BugajLab/thermoPlate/thermoPlate model_ShinyApp/simPlaceHolder.png

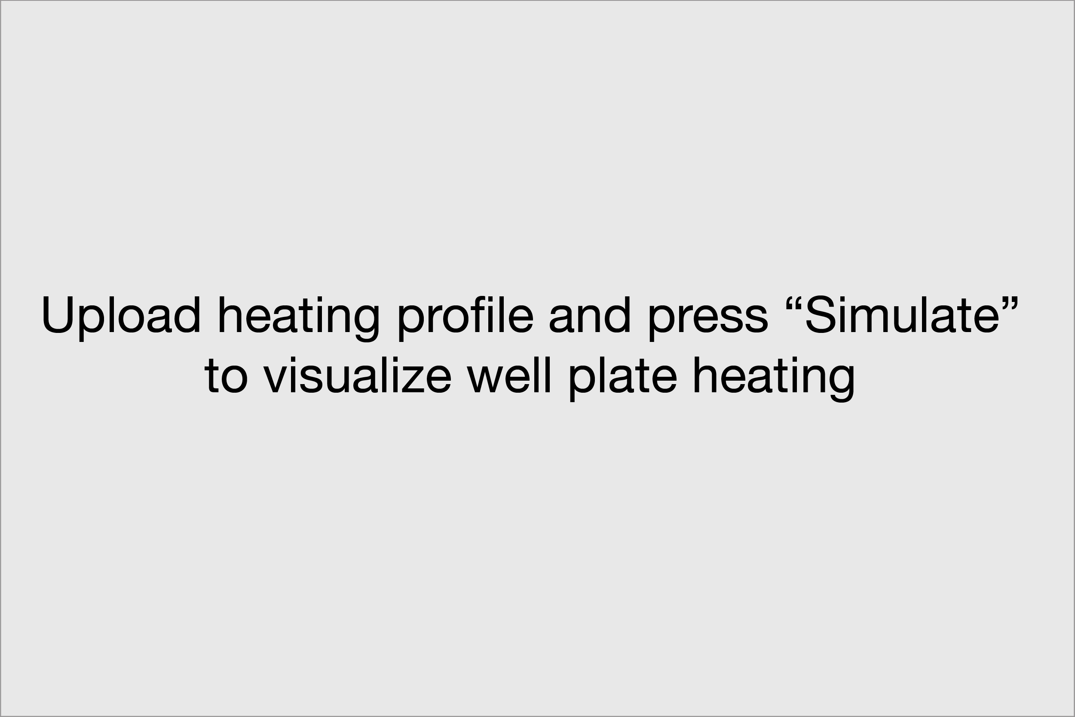
thermoPlate model_ShinyApp/simPlaceHolder.png
