BugajLab/thermoPlate/thermoPlate model_ShinyApp/www/test.gif

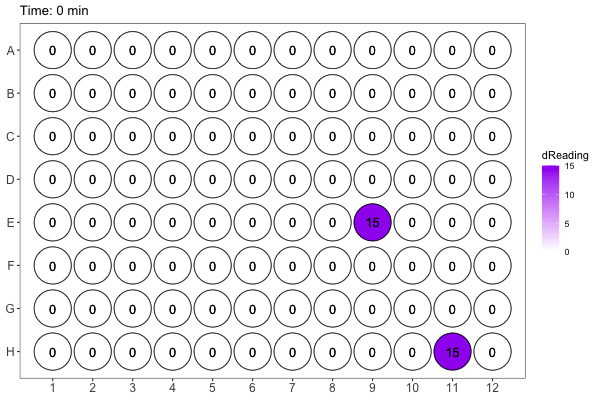
thermoPlate model_ShinyApp/www/test.gif
