BugajLab/thermoPlate/Design files_protocols_manuals/ThermoPlate PCB files/ThermoPlate2_v1.kicad_pcb

## KiCad design Design files_protocols_manuals/ThermoPlate PCB files/ThermoPlate2_v1.kicad_pcb (2024-08-28)

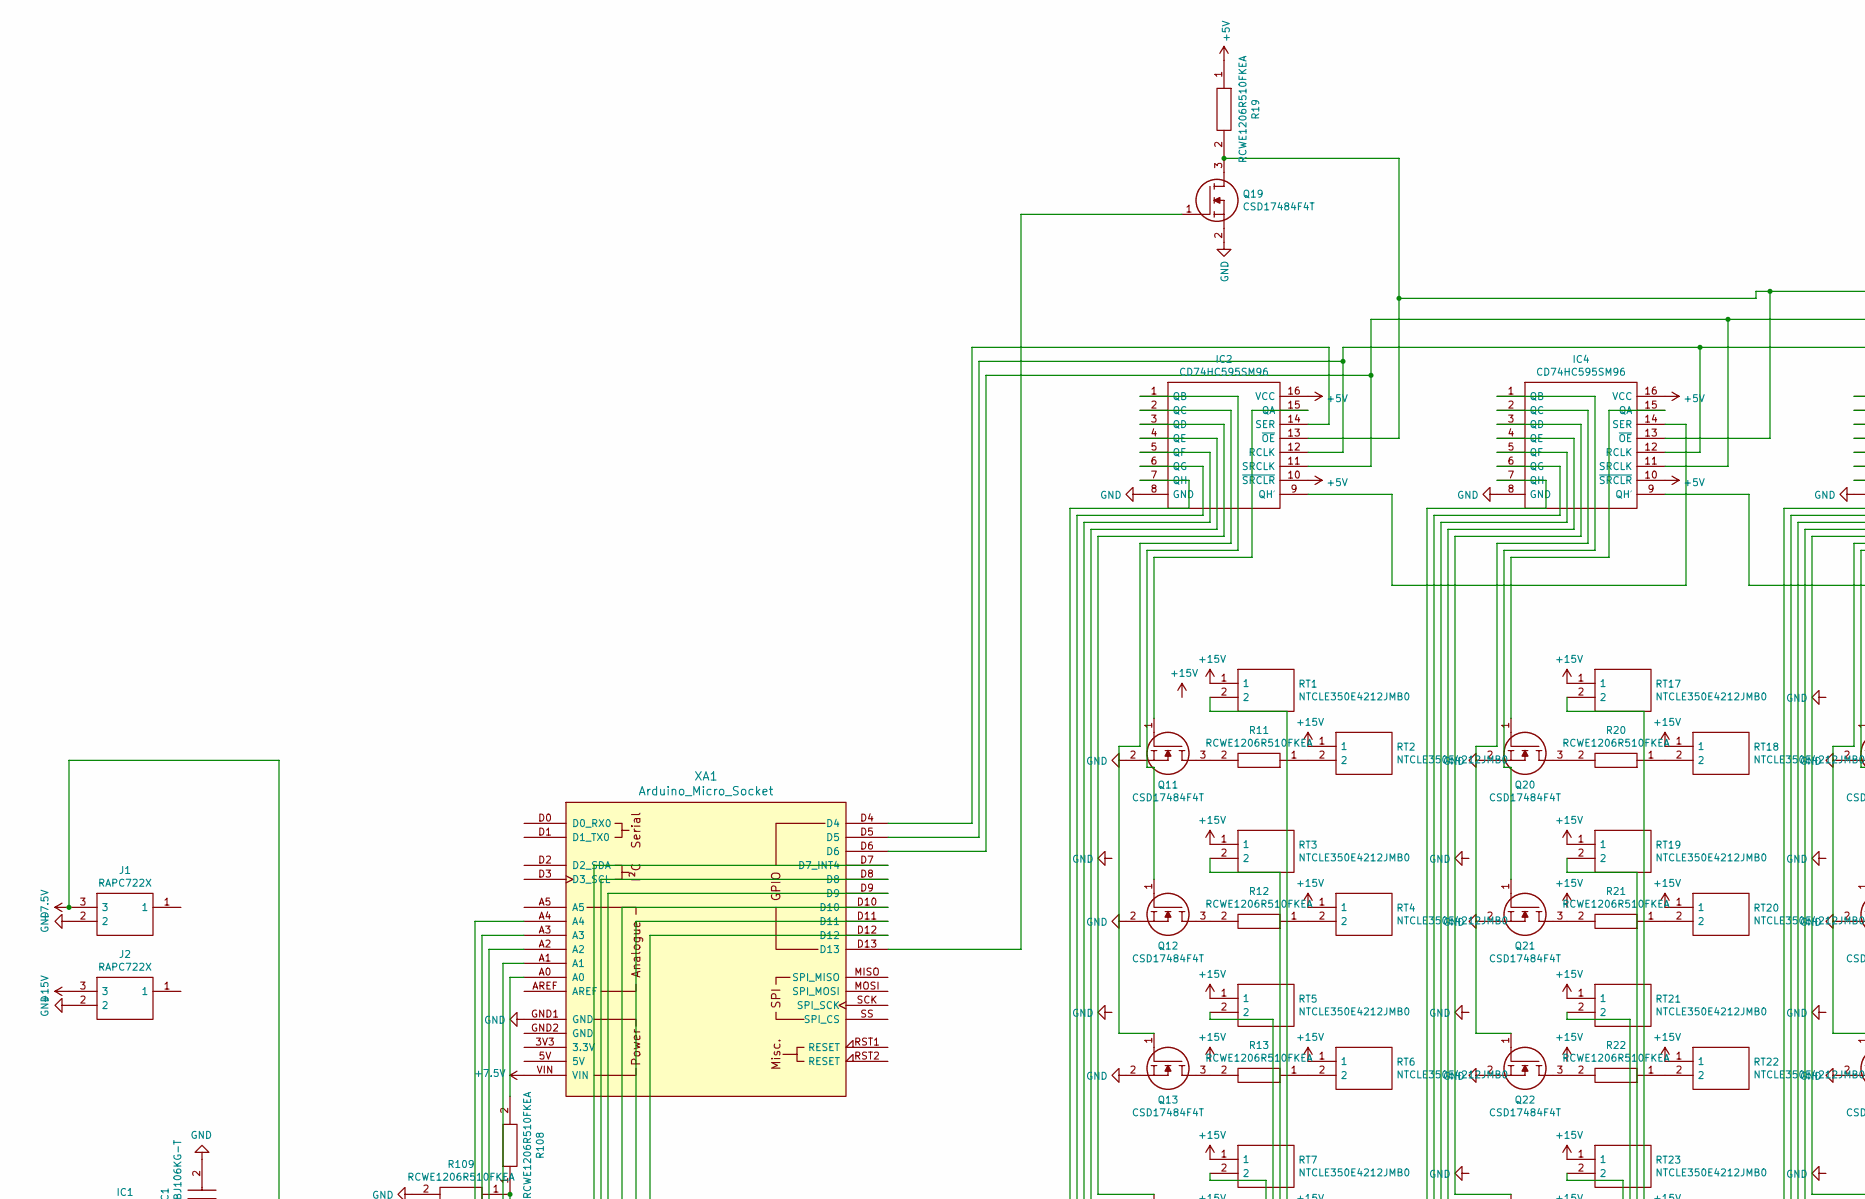
[picture p8: schematic ThermoPlate2_v1.sch, part in row 1, column 1]

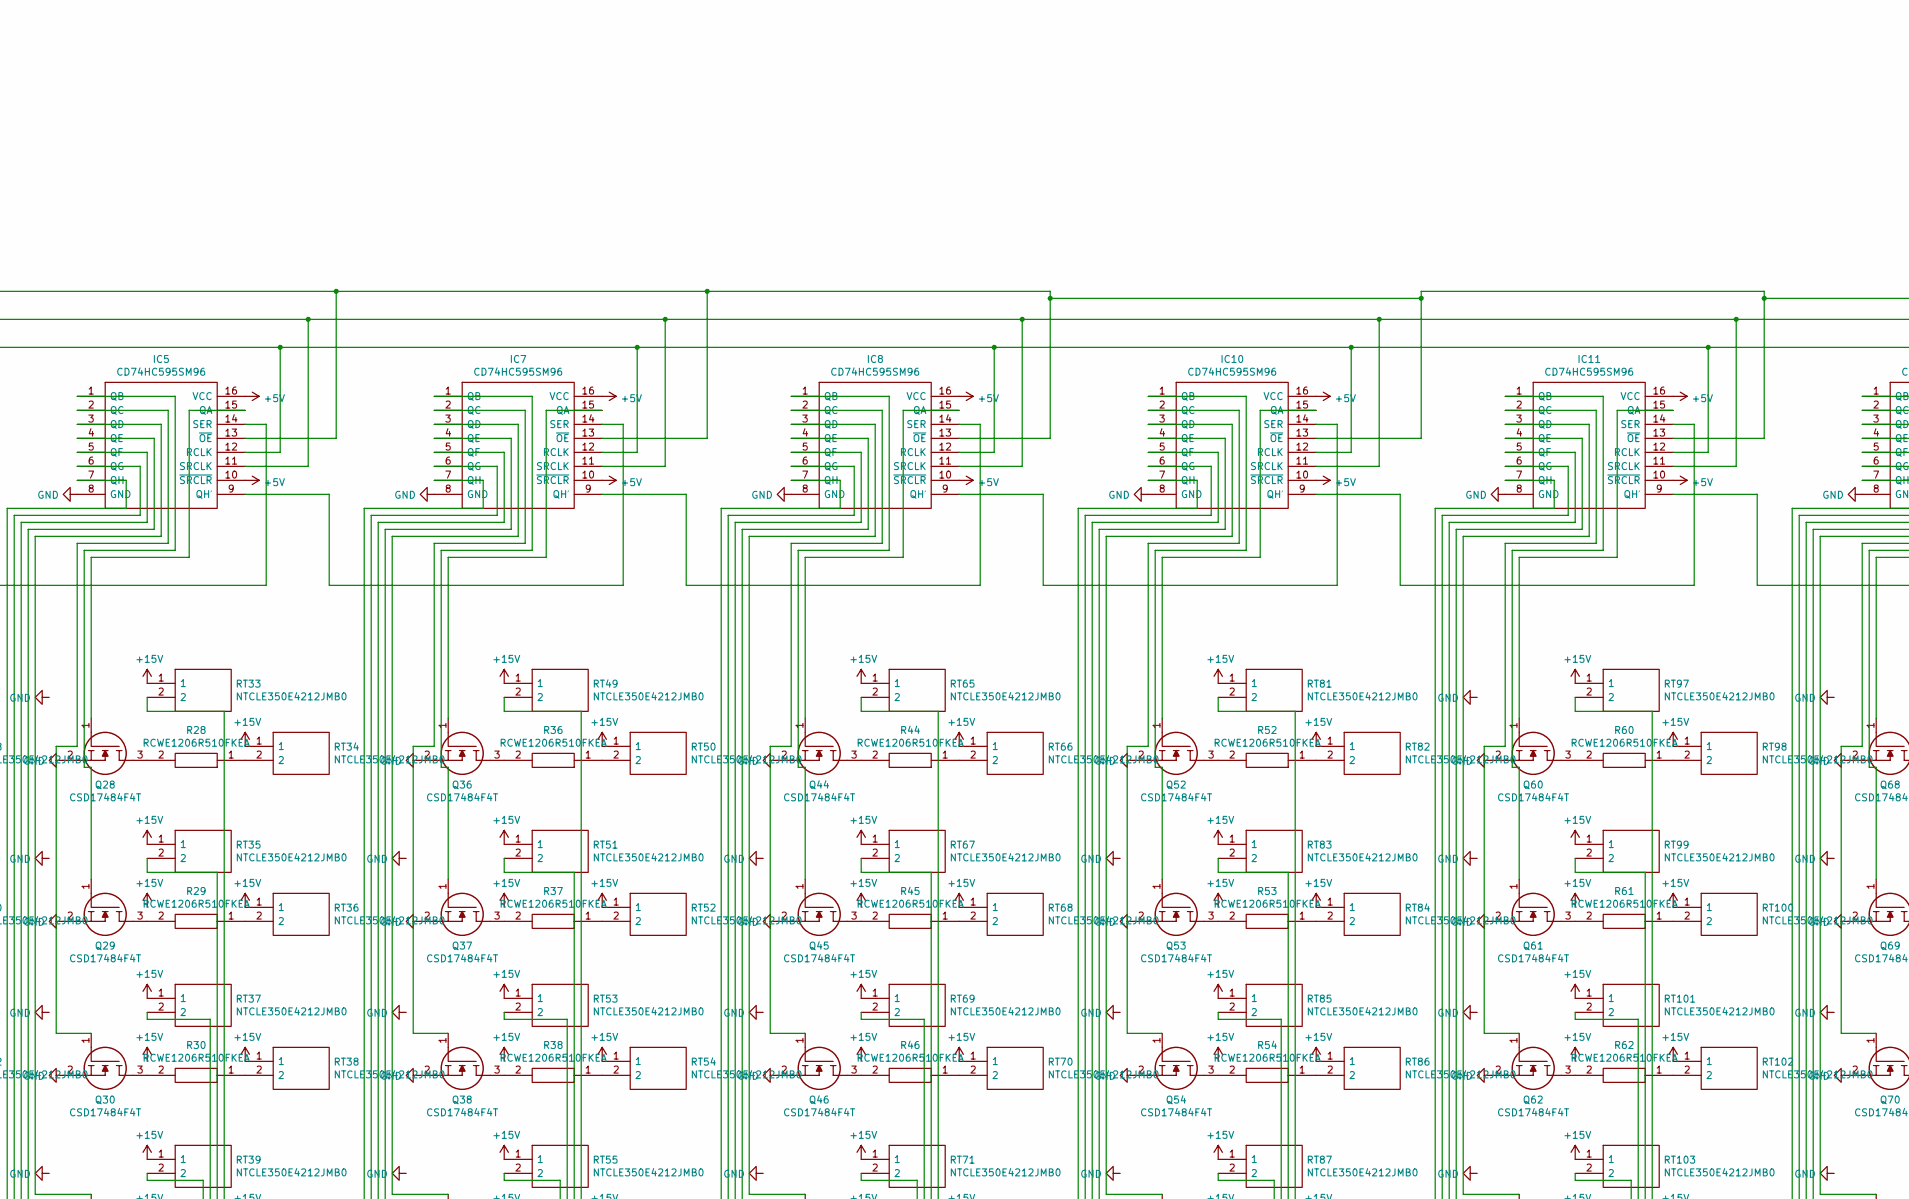
[picture p9: schematic ThermoPlate2_v1.sch, part in row 1, column 2]

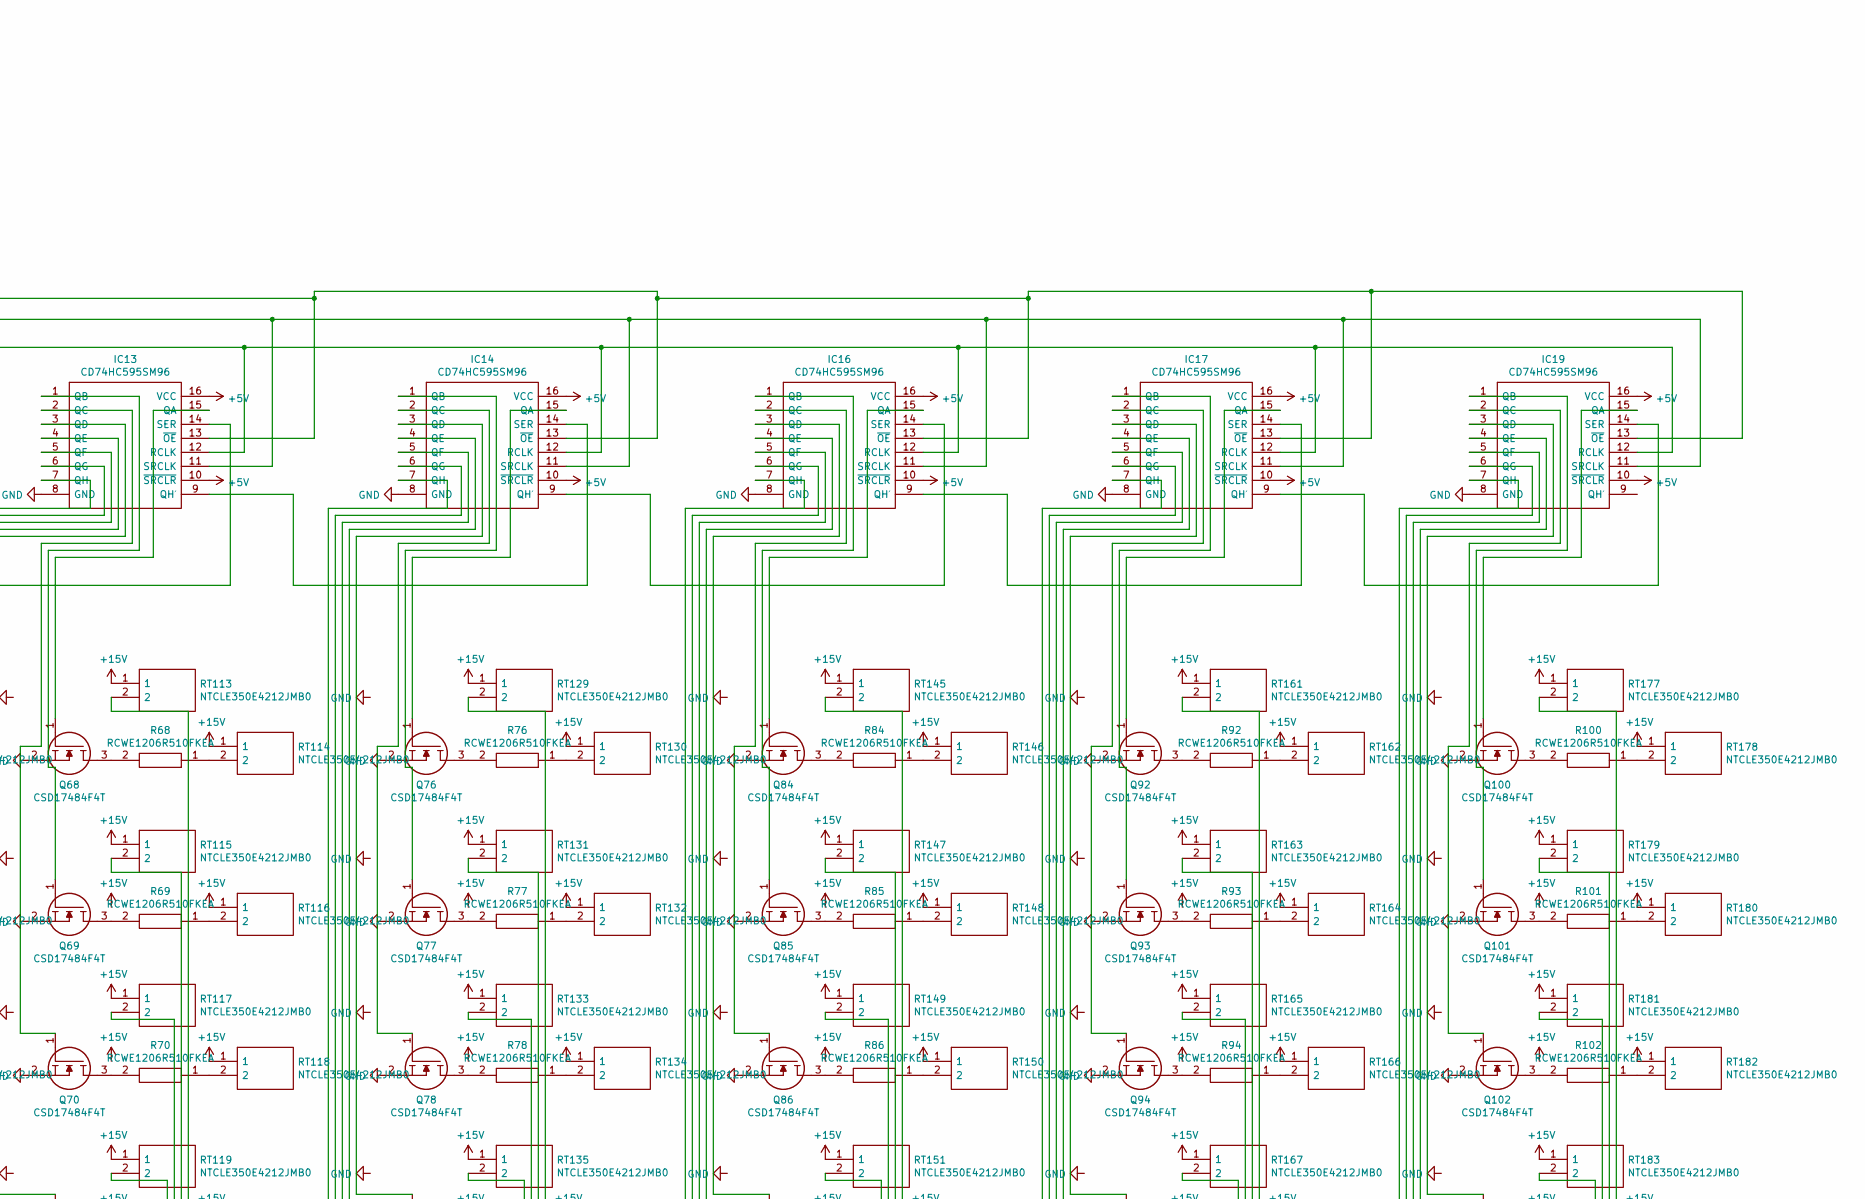
[picture p10: schematic ThermoPlate2_v1.sch, part in row 1, column 3]

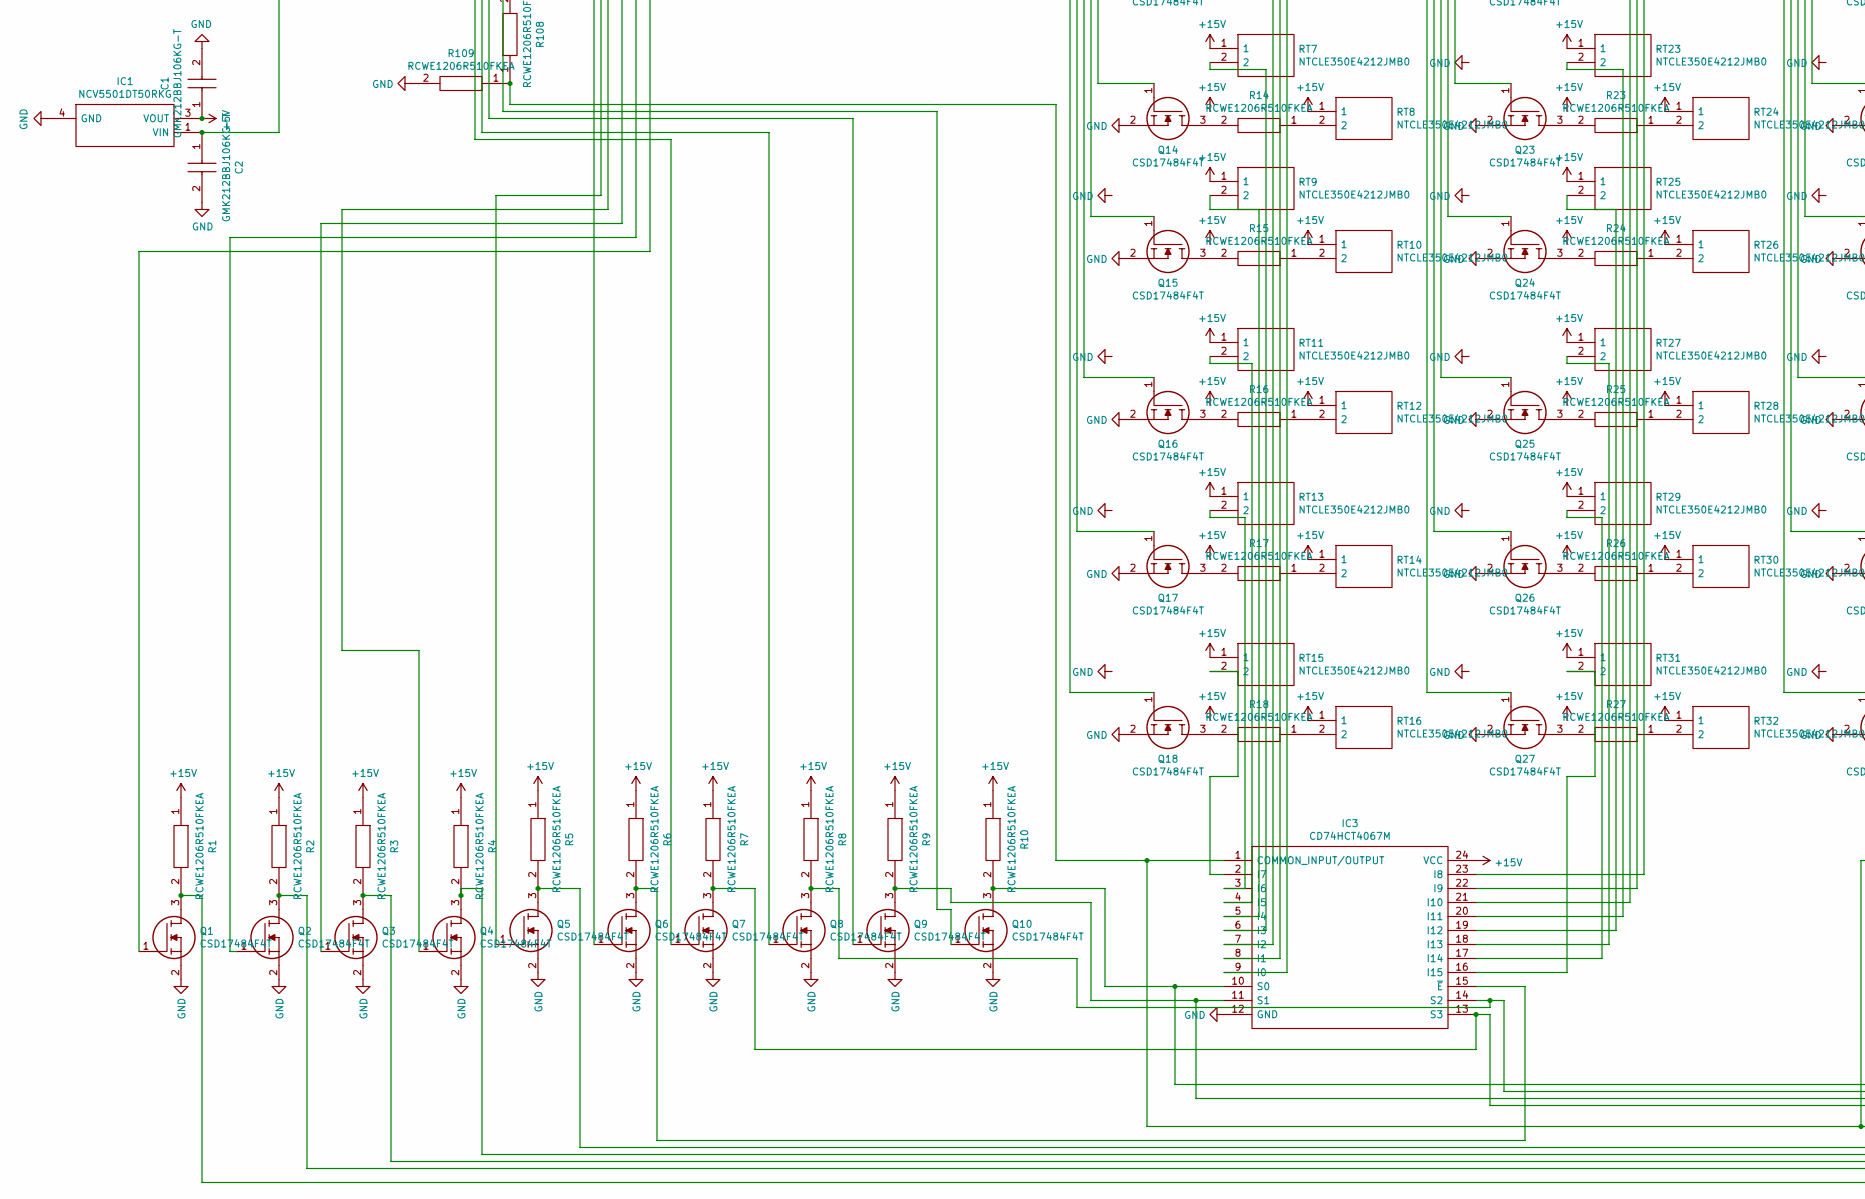
[picture p11: schematic ThermoPlate2_v1.sch, part in row 2, column 1]

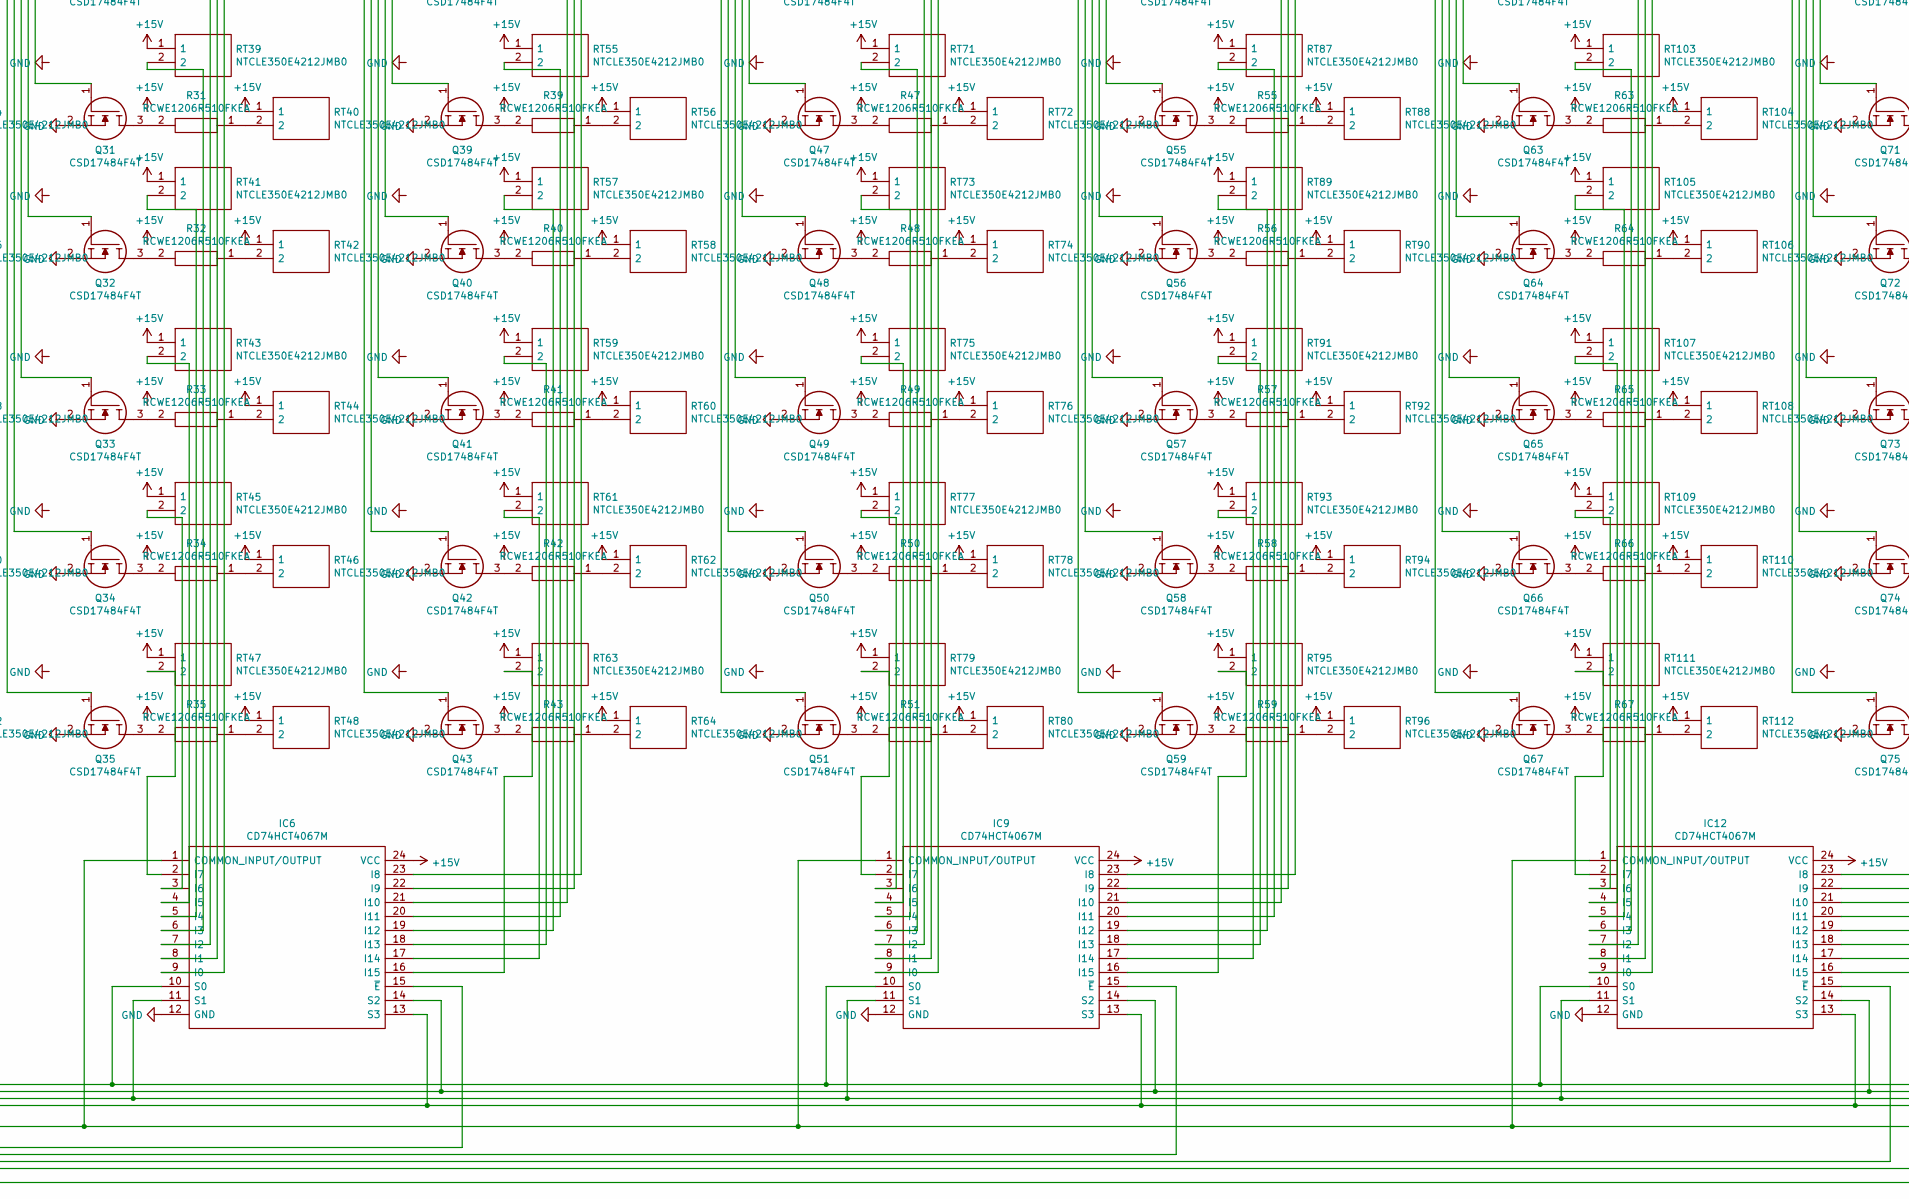
[picture p12: schematic ThermoPlate2_v1.sch, part in row 2, column 2]

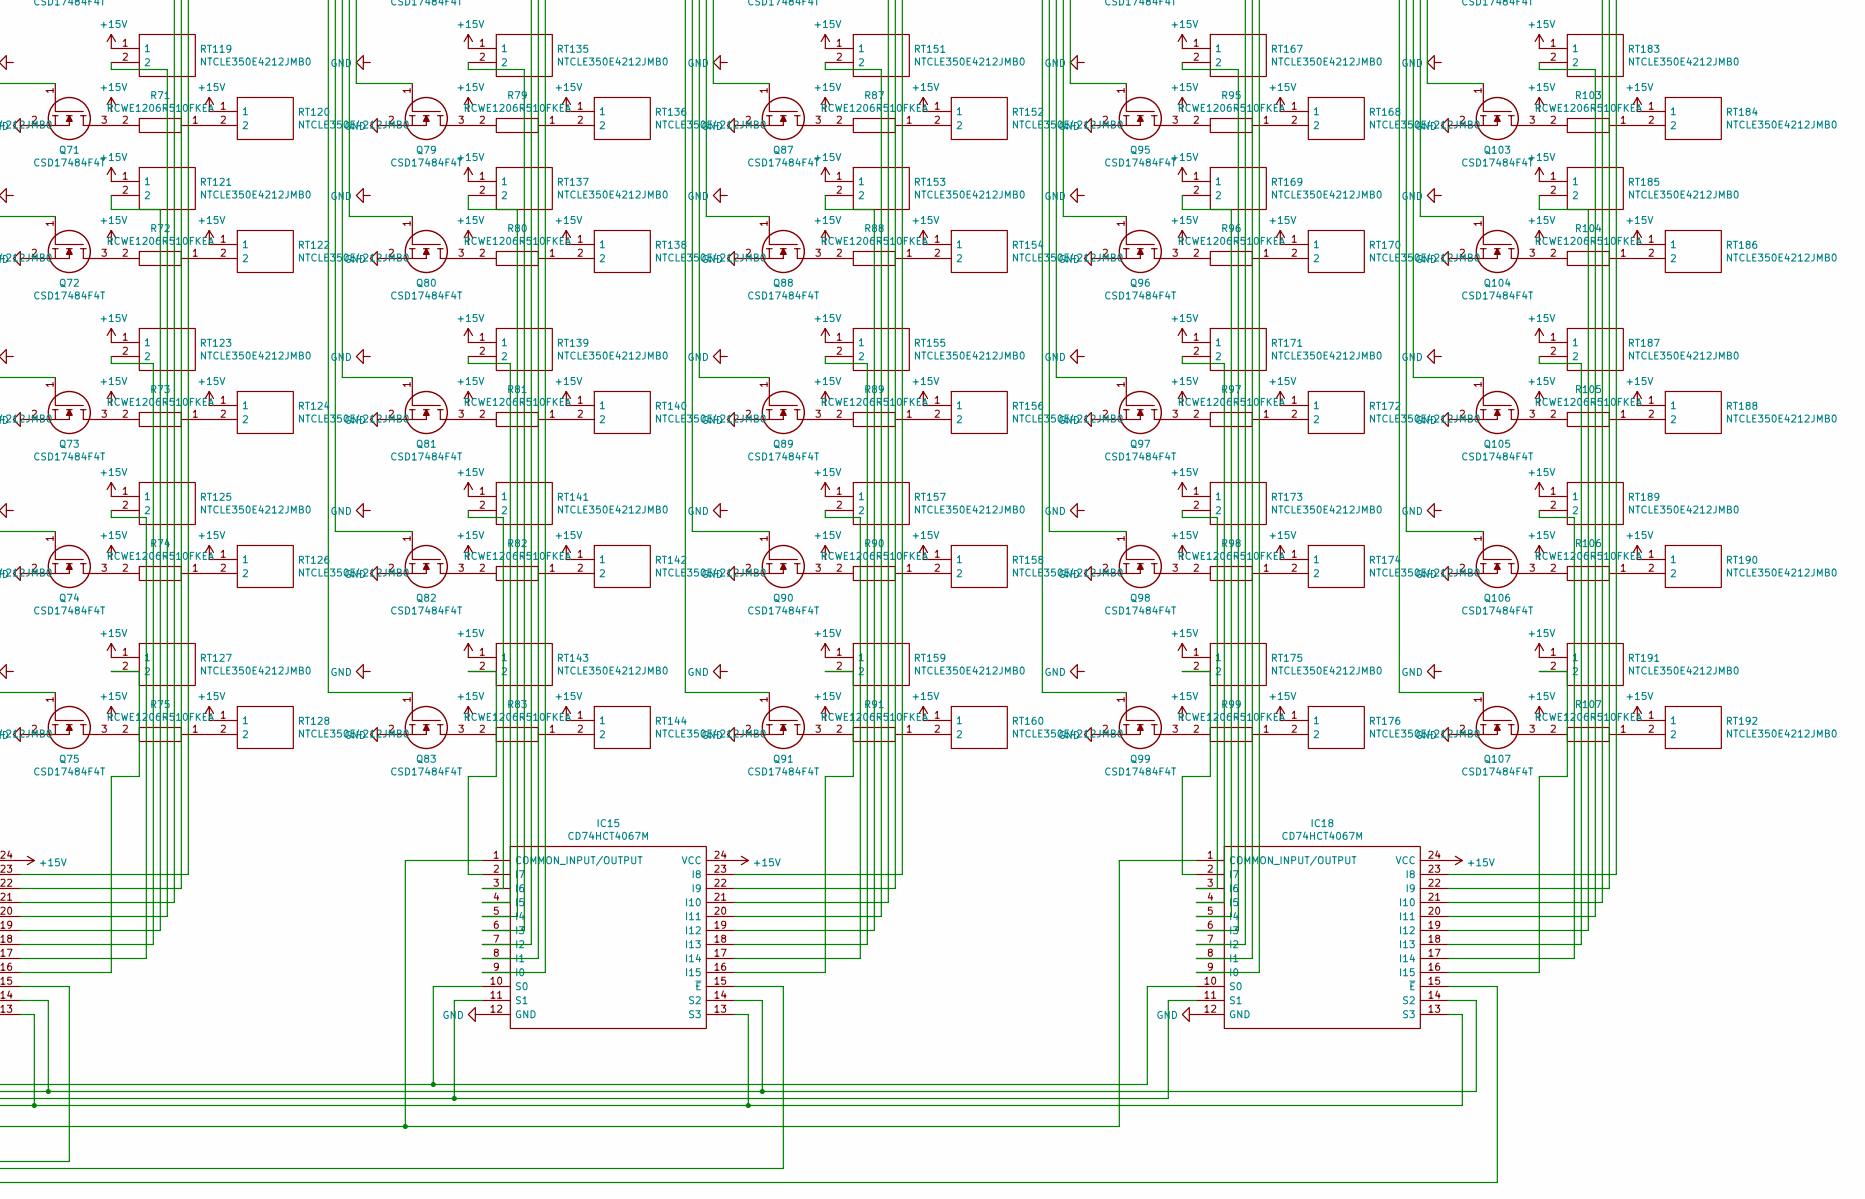
[picture p13: schematic ThermoPlate2_v1.sch, part in row 2, column 3]

Parts:
C1, C2: GMK212BBJ106KG-T; CAPC2012X135N; Mouser Part Number 963-GMK212BBJ106KG-T
IC1: NCV5501DT50RKG; Mouser Part Number 863-NCV5501DT50RKG
IC2, IC4, IC5, IC7, IC8, IC10, IC11, IC13, IC14, IC16, IC17, IC19: CD74HC595SM96; SOP65P780X200-16N; Mouser Part Number 595-CD74HC595SM96
IC3, IC6, IC9, IC12, IC15, IC18: CD74HCT4067M; SOIC127P1030X265-24N; Mouser Part Number 595-CD74HCT4067M
J1, J2: RAPC722X; Mouser Part Number 502-RAPC722X
Q1, Q2, Q3, Q4, Q5, Q6, Q7, Q8, Q9, Q10, Q11, Q12, Q13, Q14, Q15, Q16, Q17, Q18, Q19, Q20, Q21, Q22, Q23, Q24, Q25, Q26, Q27, Q28, Q29, Q30, Q31, Q32, Q33, Q34, Q35, Q36, Q37, Q38, Q39, Q40, Q41, Q42, Q43, Q44, Q45, Q46, Q47, Q48, Q49, Q50, Q51, Q52, Q53, Q54, Q55, Q56, Q57, Q58, Q59, Q60, Q61, Q62, Q63, Q64, Q65, Q66, Q67, Q68, Q69, Q70, Q71, Q72, Q73, Q74, Q75, Q76, Q77, Q78, Q79, Q80, Q81, Q82, Q83, Q84, Q85, Q86, Q87, Q88, Q89, Q90, Q91, Q92, Q93, Q94, Q95, Q96, Q97, Q98, Q99, Q100, Q101, Q102, Q103, Q104, Q105, Q106, Q107: CSD17484F4T; SOT95P230X110-3N; Mouser Part Number 595-CSD17484F4T
R1, R2, R3, R4, R5, R6, R7, R8, R9, R10, R11, R12, R13, R14, R15, R16, R17, R18, R19, R20, R21, R22, R23, R24, R25, R26, R27, R28, R29, R30, R31, R32, R33, R34, R35, R36, R37, R38, R39, R40, R41, R42, R43, R44, R45, R46, R47, R48, R49, R50, R51, R52, R53, R54, R55, R56, R57, R58, R59, R60, R61, R62, R63, R64, R65, R66, R67, R68, R69, R70, R71, R72, R73, R74, R75, R76, R77, R78, R79, R80, R81, R82, R83, R84, R85, R86, R87, R88, R89, R90, R91, R92, R93, R94, R95, R96, R97, R98, R99, R100, R101, R102, R103, R104, R105, R106, R107, R108, R109: RCWE1206R510FKEA; RESC3216X71N; Mouser Part Number 71-RCWE1206R510FKEA
RT1, RT2, RT3, RT4, RT5, RT6, RT7, RT8, RT9, RT10, RT11, RT12, RT13, RT14, RT15, RT16, RT17, RT18, RT19, RT20, RT21, RT22, RT23, RT24, RT25, RT26, RT27, RT28, RT29, RT30, RT31, RT32, RT33, RT34, RT35, RT36, RT37, RT38, RT39, RT40, RT41, RT42, RT43, RT44, RT45, RT46, RT47, RT48, RT49, RT50, RT51, RT52, RT53, RT54, RT55, RT56, RT57, RT58, RT59, RT60, RT61, RT62, RT63, RT64, RT65, RT66, RT67, RT68, RT69, RT70, RT71, RT72, RT73, RT74, RT75, RT76, RT77, RT78, RT79, RT80, RT81, RT82, RT83, RT84, RT85, RT86, RT87, RT88, RT89, RT90, RT91, RT92, RT93, RT94, RT95, RT96, RT97, RT98, RT99, RT100, RT101, RT102, RT103, RT104, RT105, RT106, RT107, RT108, RT109, RT110, RT111, RT112, RT113, RT114, RT115, RT116, RT117, RT118, RT119, RT120, RT121, RT122, RT123, RT124, RT125, RT126, RT127, RT128, RT129, RT130, RT131, RT132, RT133, RT134, RT135, RT136, RT137, RT138, RT139, RT140, RT141, RT142, RT143, RT144, RT145, RT146, RT147, RT148, RT149, RT150, RT151, RT152, RT153, RT154, RT155, RT156, RT157, RT158, RT159, RT160, RT161, RT162, RT163, RT164, RT165, RT166, RT167, RT168, RT169, RT170, RT171, RT172, RT173, RT174, RT175, RT176, RT177, RT178, RT179, RT180, RT181, RT182, RT183, RT184, RT185, RT186, RT187, RT188, RT189, RT190, RT191, RT192: NTCLE350E4212JMB0; NTCLE350E4103FHB0; Mouser Part Number 594-NTCLE350E4212JMB
XA1: Arduino_Micro_Socket

Connections:
+5V: C1.1, IC1.3 (VOUT), IC2.10 (~SRCLR), IC2.16 (VCC), IC4.10 (~SRCLR), IC4.16 (VCC), IC5.10 (~SRCLR), IC5.16 (VCC), IC7.10 (~SRCLR), IC7.16 (VCC), IC8.10 (~SRCLR), IC8.16 (VCC), IC10.10 (~SRCLR), IC10.16 (VCC), IC11.10 (~SRCLR), IC11.16 (VCC), IC13.10 (~SRCLR), IC13.16 (VCC), IC14.10 (~SRCLR), IC14.16 (VCC), IC16.10 (~SRCLR), IC16.16 (VCC), IC17.10 (~SRCLR), IC17.16 (VCC), IC19.10 (~SRCLR), IC19.16 (VCC), R19.1
+7.5V: C2.1, IC1.1 (VIN), J1.3, XA1.VIN
+15V: IC3.24 (VCC), IC6.24 (VCC), IC9.24 (VCC), IC12.24 (VCC), IC15.24 (VCC), IC18.24 (VCC), J2.3, R1.1, R2.1, R3.1, R4.1, R5.1, R6.1, R7.1, R8.1, R9.1, R10.1, RT1.1, RT2.1, RT3.1, RT4.1, RT5.1, RT6.1, RT7.1, RT8.1, RT9.1, RT10.1, RT11.1, RT12.1, RT13.1, RT14.1, RT15.1, RT16.1, RT17.1, RT18.1, RT19.1, RT20.1, RT21.1, RT22.1, RT23.1, RT24.1, RT25.1, RT26.1, RT27.1, RT28.1, RT29.1, RT30.1, RT31.1, RT32.1, RT33.1, RT34.1, RT35.1, RT36.1, RT37.1, RT38.1, RT39.1, RT40.1, RT41.1, RT42.1, RT43.1, RT44.1, RT45.1, RT46.1, RT47.1, RT48.1, RT49.1, RT50.1, RT51.1, RT52.1, RT53.1, RT54.1, RT55.1, RT56.1, RT57.1, RT58.1, RT59.1, RT60.1, RT61.1, RT62.1, RT63.1, RT64.1, RT65.1, RT66.1, RT67.1, RT68.1, RT69.1, RT70.1, RT71.1, RT72.1, RT73.1, RT74.1, RT75.1, RT76.1, RT77.1, RT78.1, RT79.1, RT80.1, RT81.1, RT82.1, RT83.1, RT84.1, RT85.1, RT86.1, RT87.1, RT88.1, RT89.1, RT90.1, RT91.1, RT92.1, RT93.1, RT94.1, RT95.1, RT96.1, RT97.1, RT98.1, RT99.1, RT100.1, RT101.1, RT102.1, RT103.1, RT104.1, RT105.1, RT106.1, RT107.1, RT108.1, RT109.1, RT110.1, RT111.1, RT112.1, RT113.1, RT114.1, RT115.1, RT116.1, RT117.1, RT118.1, RT119.1, RT120.1, RT121.1, RT122.1, RT123.1, RT124.1, RT125.1, RT126.1, RT127.1, RT128.1, RT129.1, RT130.1, RT131.1, RT132.1, RT133.1, RT134.1, RT135.1, RT136.1, RT137.1, RT138.1, RT139.1, RT140.1, RT141.1, RT142.1, RT143.1, RT144.1, RT145.1, RT146.1, RT147.1, RT148.1, RT149.1, RT150.1, RT151.1, RT152.1, RT153.1, RT154.1, RT155.1, RT156.1, RT157.1, RT158.1, RT159.1, RT160.1, RT161.1, RT162.1, RT163.1, RT164.1, RT165.1, RT166.1, RT167.1, RT168.1, RT169.1, RT170.1, RT171.1, RT172.1, RT173.1, RT174.1, RT175.1, RT176.1, RT177.1, RT178.1, RT179.1, RT180.1, RT181.1, RT182.1, RT183.1, RT184.1, RT185.1, RT186.1, RT187.1, RT188.1, RT189.1, RT190.1, RT191.1, RT192.1
GND: C1.2, C2.2, IC1.4 (GND), IC2.8 (GND), IC3.12 (GND), IC4.8 (GND), IC5.8 (GND), IC6.12 (GND), IC7.8 (GND), IC8.8 (GND), IC9.12 (GND), IC10.8 (GND), IC11.8 (GND), IC12.12 (GND), IC13.8 (GND), IC14.8 (GND), IC15.12 (GND), IC16.8 (GND), IC17.8 (GND), IC18.12 (GND), IC19.8 (GND), J1.2, J2.2, Q1.2, Q2.2, Q3.2, Q4.2, Q5.2, Q6.2, Q7.2, Q8.2, Q9.2, Q10.2, Q11.2, Q12.2, Q13.2, Q14.2, Q15.2, Q16.2, Q17.2, Q18.2, Q19.2, Q20.2, Q21.2, Q22.2, Q23.2, Q24.2, Q25.2, Q26.2, Q27.2, Q28.2, Q29.2, Q30.2, Q31.2, Q32.2, Q33.2, Q34.2, Q35.2, Q36.2, Q37.2, Q38.2, Q39.2, Q40.2, Q41.2, Q42.2, Q43.2, Q44.2, Q45.2, Q46.2, Q47.2, Q48.2, Q49.2, Q50.2, Q51.2, Q52.2, Q53.2, Q54.2, Q55.2, Q56.2, Q57.2, Q58.2, Q59.2, Q60.2, Q61.2, Q62.2, Q63.2, Q64.2, Q65.2, Q66.2, Q67.2, Q68.2, Q69.2, Q70.2, Q71.2, Q72.2, Q73.2, Q74.2, Q75.2, Q76.2, Q77.2, Q78.2, Q79.2, Q80.2, Q81.2, Q82.2, Q83.2, Q84.2, Q85.2, Q86.2, Q87.2, Q88.2, Q89.2, Q90.2, Q91.2, Q92.2, Q93.2, Q94.2, Q95.2, Q96.2, Q97.2, Q98.2, Q99.2, Q100.2, Q101.2, Q102.2, Q103.2, Q104.2, Q105.2, Q106.2, Q107.2, R109.2, XA1.GND1 (GND)
unnamed: IC2.1 (QB), Q12.1
unnamed: IC2.2 (QC), Q13.1
unnamed: IC2.3 (QD), Q14.1
unnamed: IC2.4 (QE), Q15.1
unnamed: IC2.5 (QF), Q16.1
unnamed: IC2.6 (QG), Q17.1
unnamed: IC2.7 (QH), Q18.1
unnamed: IC2.9 (QH′), IC4.14 (SER)
unnamed: IC2.14 (SER), XA1.D4
unnamed: IC2.15 (QA), Q11.1
unnamed: IC3.2 (I7), RT15.2
unnamed: IC3.3 (I6), RT13.2
unnamed: IC3.4 (I5), RT11.2
unnamed: IC3.5 (I4), RT9.2
unnamed: IC3.6 (I3), RT7.2
unnamed: IC3.7 (I2), RT5.2
unnamed: IC3.8 (I1), RT3.2
unnamed: IC3.9 (I0), RT1.2
unnamed: IC3.15 (~E), Q6.3, R6.2
unnamed: IC3.16 (I15), RT31.2
unnamed: IC3.17 (I14), RT29.2
unnamed: IC3.18 (I13), RT27.2
unnamed: IC3.19 (I12), RT25.2
unnamed: IC3.20 (I11), RT23.2
unnamed: IC3.21 (I10), RT21.2
unnamed: IC3.22 (I9), RT19.2
unnamed: IC3.23 (I8), RT17.2
unnamed: IC4.1 (QB), Q21.1
unnamed: IC4.2 (QC), Q22.1
unnamed: IC4.3 (QD), Q23.1
unnamed: IC4.4 (QE), Q24.1
unnamed: IC4.5 (QF), Q25.1
unnamed: IC4.6 (QG), Q26.1
unnamed: IC4.7 (QH), Q27.1
unnamed: IC4.9 (QH′), IC5.14 (SER)
unnamed: IC4.15 (QA), Q20.1
unnamed: IC5.1 (QB), Q29.1
unnamed: IC5.2 (QC), Q30.1
unnamed: IC5.3 (QD), Q31.1
unnamed: IC5.4 (QE), Q32.1
unnamed: IC5.5 (QF), Q33.1
unnamed: IC5.6 (QG), Q34.1
unnamed: IC5.7 (QH), Q35.1
unnamed: IC5.9 (QH′), IC7.14 (SER)
unnamed: IC5.15 (QA), Q28.1
unnamed: IC6.2 (I7), RT47.2
unnamed: IC6.3 (I6), RT45.2
unnamed: IC6.4 (I5), RT43.2
unnamed: IC6.5 (I4), RT41.2
unnamed: IC6.6 (I3), RT39.2
unnamed: IC6.7 (I2), RT37.2
unnamed: IC6.8 (I1), RT35.2
unnamed: IC6.9 (I0), RT33.2
unnamed: IC6.15 (~E), Q5.3, R5.2
unnamed: IC6.16 (I15), RT63.2
unnamed: IC6.17 (I14), RT61.2
unnamed: IC6.18 (I13), RT59.2
unnamed: IC6.19 (I12), RT57.2
unnamed: IC6.20 (I11), RT55.2
unnamed: IC6.21 (I10), RT53.2
unnamed: IC6.22 (I9), RT51.2
unnamed: IC6.23 (I8), RT49.2
unnamed: IC7.1 (QB), Q37.1
unnamed: IC7.2 (QC), Q38.1
unnamed: IC7.3 (QD), Q39.1
unnamed: IC7.4 (QE), Q40.1
unnamed: IC7.5 (QF), Q41.1
unnamed: IC7.6 (QG), Q42.1
unnamed: IC7.7 (QH), Q43.1
unnamed: IC7.9 (QH′), IC8.14 (SER)
unnamed: IC7.15 (QA), Q36.1
unnamed: IC8.1 (QB), Q45.1
unnamed: IC8.2 (QC), Q46.1
unnamed: IC8.3 (QD), Q47.1
unnamed: IC8.4 (QE), Q48.1
unnamed: IC8.5 (QF), Q49.1
unnamed: IC8.6 (QG), Q50.1
unnamed: IC8.7 (QH), Q51.1
unnamed: IC8.15 (QA), Q44.1
unnamed: IC9.2 (I7), RT79.2
unnamed: IC9.3 (I6), RT77.2
unnamed: IC9.4 (I5), RT75.2
unnamed: IC9.5 (I4), RT73.2
unnamed: IC9.6 (I3), RT71.2
unnamed: IC9.7 (I2), RT69.2
unnamed: IC9.8 (I1), RT67.2
unnamed: IC9.9 (I0), RT65.2
unnamed: IC9.15 (~E), Q4.3, R4.2
unnamed: IC9.16 (I15), RT95.2
unnamed: IC9.17 (I14), RT93.2
unnamed: IC9.18 (I13), RT91.2
unnamed: IC9.19 (I12), RT89.2
unnamed: IC9.20 (I11), RT87.2
unnamed: IC9.21 (I10), RT85.2
unnamed: IC9.22 (I9), RT83.2
unnamed: IC9.23 (I8), RT81.2
unnamed: IC10.1 (QB), Q53.1
unnamed: IC10.2 (QC), Q54.1
unnamed: IC10.3 (QD), Q55.1
unnamed: IC10.4 (QE), Q56.1
unnamed: IC10.5 (QF), Q57.1
unnamed: IC10.6 (QG), Q58.1
unnamed: IC10.7 (QH), Q59.1
unnamed: IC10.9 (QH′), IC11.14 (SER)
unnamed: IC2.11 (SRCLK), IC4.11 (SRCLK), IC5.11 (SRCLK), IC7.11 (SRCLK), IC8.11 (SRCLK), IC10.11 (SRCLK), IC11.11 (SRCLK), IC13.11 (SRCLK), IC14.11 (SRCLK), IC16.11 (SRCLK), IC17.11 (SRCLK), IC19.11 (SRCLK), XA1.D6
unnamed: IC2.12 (RCLK), IC4.12 (RCLK), IC5.12 (RCLK), IC7.12 (RCLK), IC8.12 (RCLK), IC10.12 (RCLK), IC11.12 (RCLK), IC13.12 (RCLK), IC14.12 (RCLK), IC16.12 (RCLK), IC17.12 (RCLK), IC19.12 (RCLK), XA1.D5
unnamed: IC2.13 (~OE), IC4.13 (~OE), IC5.13 (~OE), IC7.13 (~OE), IC8.13 (~OE), IC10.13 (~OE), IC11.13 (~OE), IC13.13 (~OE), IC14.13 (~OE), IC16.13 (~OE), IC17.13 (~OE), IC19.13 (~OE), Q19.3, R19.2
unnamed: IC8.9 (QH′), IC10.14 (SER)
unnamed: IC10.15 (QA), Q52.1
unnamed: IC11.1 (QB), Q61.1
unnamed: IC11.2 (QC), Q62.1
unnamed: IC11.3 (QD), Q63.1
unnamed: IC11.4 (QE), Q64.1
unnamed: IC11.5 (QF), Q65.1
unnamed: IC11.6 (QG), Q66.1
unnamed: IC11.7 (QH), Q67.1
unnamed: IC11.9 (QH′), IC13.14 (SER)
unnamed: IC11.15 (QA), Q60.1
unnamed: IC3.1 (COMMON_INPUT/OUTPUT), IC6.1 (COMMON_INPUT/OUTPUT), IC9.1 (COMMON_INPUT/OUTPUT), IC12.1 (COMMON_INPUT/OUTPUT), IC15.1 (COMMON_INPUT/OUTPUT), IC18.1 (COMMON_INPUT/OUTPUT), R108.1, R109.1
unnamed: IC12.2 (I7), RT111.2
unnamed: IC12.3 (I6), RT109.2
unnamed: IC12.4 (I5), RT107.2
unnamed: IC12.5 (I4), RT105.2
unnamed: IC12.6 (I3), RT103.2
unnamed: IC12.7 (I2), RT101.2
unnamed: IC12.8 (I1), RT99.2
unnamed: IC12.9 (I0), RT97.2
unnamed: IC3.10 (S0), IC6.10 (S0), IC9.10 (S0), IC12.10 (S0), IC15.10 (S0), IC18.10 (S0), Q10.3, R10.2
unnamed: IC3.11 (S1), IC6.11 (S1), IC9.11 (S1), IC12.11 (S1), IC15.11 (S1), IC18.11 (S1), Q9.3, R9.2
unnamed: IC3.13 (S3), IC6.13 (S3), IC9.13 (S3), IC12.13 (S3), IC15.13 (S3), IC18.13 (S3), Q7.3, R7.2
unnamed: IC3.14 (S2), IC6.14 (S2), IC9.14 (S2), IC12.14 (S2), IC15.14 (S2), IC18.14 (S2), Q8.3, R8.2
unnamed: IC12.15 (~E), Q3.3, R3.2
unnamed: IC12.16 (I15), RT127.2
unnamed: IC12.17 (I14), RT125.2
unnamed: IC12.18 (I13), RT123.2
unnamed: IC12.19 (I12), RT121.2
unnamed: IC12.20 (I11), RT119.2
unnamed: IC12.21 (I10), RT117.2
unnamed: IC12.22 (I9), RT115.2
unnamed: IC12.23 (I8), RT113.2
unnamed: IC13.1 (QB), Q69.1
unnamed: IC13.2 (QC), Q70.1
unnamed: IC13.3 (QD), Q71.1
unnamed: IC13.4 (QE), Q72.1
unnamed: IC13.5 (QF), Q73.1
unnamed: IC13.6 (QG), Q74.1
unnamed: IC13.7 (QH), Q75.1
unnamed: IC13.9 (QH′), IC14.14 (SER)
unnamed: IC13.15 (QA), Q68.1
unnamed: IC14.1 (QB), Q77.1
unnamed: IC14.2 (QC), Q78.1
unnamed: IC14.3 (QD), Q79.1
unnamed: IC14.4 (QE), Q80.1
unnamed: IC14.5 (QF), Q81.1
unnamed: IC14.6 (QG), Q82.1
unnamed: IC14.7 (QH), Q83.1
unnamed: IC14.9 (QH′), IC16.14 (SER)
unnamed: IC14.15 (QA), Q76.1
unnamed: IC15.2 (I7), RT143.2
unnamed: IC15.3 (I6), RT141.2
unnamed: IC15.4 (I5), RT139.2
unnamed: IC15.5 (I4), RT137.2
unnamed: IC15.6 (I3), RT135.2
unnamed: IC15.7 (I2), RT133.2
unnamed: IC15.8 (I1), RT131.2
unnamed: IC15.9 (I0), RT129.2
unnamed: IC15.15 (~E), Q2.3, R2.2
unnamed: IC15.16 (I15), RT159.2
unnamed: IC15.17 (I14), RT157.2
unnamed: IC15.18 (I13), RT155.2
unnamed: IC15.19 (I12), RT153.2
unnamed: IC15.20 (I11), RT151.2
unnamed: IC15.21 (I10), RT149.2
unnamed: IC15.22 (I9), RT147.2
unnamed: IC15.23 (I8), RT145.2
unnamed: IC16.1 (QB), Q85.1
unnamed: IC16.2 (QC), Q86.1
unnamed: IC16.3 (QD), Q87.1
unnamed: IC16.4 (QE), Q88.1
unnamed: IC16.5 (QF), Q89.1
unnamed: IC16.6 (QG), Q90.1
unnamed: IC16.7 (QH), Q91.1
unnamed: IC16.9 (QH′), IC17.14 (SER)
unnamed: IC16.15 (QA), Q84.1
unnamed: IC17.1 (QB), Q93.1
unnamed: IC17.2 (QC), Q94.1
unnamed: IC17.3 (QD), Q95.1
unnamed: IC17.4 (QE), Q96.1
unnamed: IC17.5 (QF), Q97.1
unnamed: IC17.6 (QG), Q98.1
unnamed: IC17.7 (QH), Q99.1
unnamed: IC17.9 (QH′), IC19.14 (SER)
unnamed: IC17.15 (QA), Q92.1
unnamed: IC18.2 (I7), RT175.2
unnamed: IC18.3 (I6), RT173.2
unnamed: IC18.4 (I5), RT171.2
unnamed: IC18.5 (I4), RT169.2
unnamed: IC18.6 (I3), RT167.2
unnamed: IC18.7 (I2), RT165.2
unnamed: IC18.8 (I1), RT163.2
unnamed: IC18.9 (I0), RT161.2
unnamed: IC18.15 (~E), Q1.3, R1.2
unnamed: IC18.16 (I15), RT191.2
unnamed: IC18.17 (I14), RT189.2
unnamed: IC18.18 (I13), RT187.2
unnamed: IC18.19 (I12), RT185.2
unnamed: IC18.20 (I11), RT183.2
unnamed: IC18.21 (I10), RT181.2
unnamed: IC18.22 (I9), RT179.2
unnamed: IC18.23 (I8), RT177.2
unnamed: IC19.1 (QB), Q101.1
unnamed: IC19.2 (QC), Q102.1
unnamed: IC19.3 (QD), Q103.1
unnamed: IC19.4 (QE), Q104.1
unnamed: IC19.5 (QF), Q105.1
unnamed: IC19.6 (QG), Q106.1
unnamed: IC19.7 (QH), Q107.1
unnamed: IC19.15 (QA), Q100.1
unnamed: Q1.1, XA1.D12
unnamed: Q2.1, XA1.D11
unnamed: Q3.1, XA1.D10
unnamed: Q4.1, XA1.D9
unnamed: Q5.1, XA1.D8
unnamed: Q6.1, XA1.D7 (D7_INT4)
unnamed: Q7.1, XA1.A4
unnamed: Q8.1, XA1.A3
unnamed: Q9.1, XA1.A2
unnamed: Q10.1, XA1.A1
unnamed: Q11.3, R11.2
unnamed: Q12.3, R12.2
unnamed: Q13.3, R13.2
unnamed: Q14.3, R14.2
unnamed: Q15.3, R15.2
unnamed: Q16.3, R16.2
unnamed: Q17.3, R17.2
unnamed: Q18.3, R18.2
unnamed: Q19.1, XA1.D13
unnamed: Q20.3, R20.2
unnamed: Q21.3, R21.2
unnamed: Q22.3, R22.2
unnamed: Q23.3, R23.2
unnamed: Q24.3, R24.2
unnamed: Q25.3, R25.2
unnamed: Q26.3, R26.2
unnamed: Q27.3, R27.2
unnamed: Q28.3, R28.2
unnamed: Q29.3, R29.2
unnamed: Q30.3, R30.2
unnamed: Q31.3, R31.2
unnamed: Q32.3, R32.2
unnamed: Q33.3, R33.2
unnamed: Q34.3, R34.2
unnamed: Q35.3, R35.2
unnamed: Q36.3, R36.2
unnamed: Q37.3, R37.2
unnamed: Q38.3, R38.2
unnamed: Q39.3, R39.2
unnamed: Q40.3, R40.2
unnamed: Q41.3, R41.2
unnamed: Q42.3, R42.2
unnamed: Q43.3, R43.2
unnamed: Q44.3, R44.2
unnamed: Q45.3, R45.2
unnamed: Q46.3, R46.2
unnamed: Q47.3, R47.2
unnamed: Q48.3, R48.2
unnamed: Q49.3, R49.2
unnamed: Q50.3, R50.2
unnamed: Q51.3, R51.2
unnamed: Q52.3, R52.2
unnamed: Q53.3, R53.2
unnamed: Q54.3, R54.2
unnamed: Q55.3, R55.2
unnamed: Q56.3, R56.2
unnamed: Q57.3, R57.2
unnamed: Q58.3, R58.2
unnamed: Q59.3, R59.2
unnamed: Q60.3, R60.2
unnamed: Q61.3, R61.2
unnamed: Q62.3, R62.2
unnamed: Q63.3, R63.2
unnamed: Q64.3, R64.2
unnamed: Q65.3, R65.2
unnamed: Q66.3, R66.2
unnamed: Q67.3, R67.2
unnamed: Q68.3, R68.2
unnamed: Q69.3, R69.2
unnamed: Q70.3, R70.2
unnamed: Q71.3, R71.2
unnamed: Q72.3, R72.2
unnamed: Q73.3, R73.2
unnamed: Q74.3, R74.2
unnamed: Q75.3, R75.2
unnamed: Q76.3, R76.2
unnamed: Q77.3, R77.2
unnamed: Q78.3, R78.2
unnamed: Q79.3, R79.2
unnamed: Q80.3, R80.2
unnamed: Q81.3, R81.2
unnamed: Q82.3, R82.2
unnamed: Q83.3, R83.2
unnamed: Q84.3, R84.2
unnamed: Q85.3, R85.2
unnamed: Q86.3, R86.2
unnamed: Q87.3, R87.2
unnamed: Q88.3, R88.2
unnamed: Q89.3, R89.2
unnamed: Q90.3, R90.2
unnamed: Q91.3, R91.2
unnamed: Q92.3, R92.2
unnamed: Q93.3, R93.2
unnamed: Q94.3, R94.2
unnamed: Q95.3, R95.2
unnamed: Q96.3, R96.2
unnamed: Q97.3, R97.2
unnamed: Q98.3, R98.2
unnamed: Q99.3, R99.2
unnamed: Q100.3, R100.2
unnamed: Q101.3, R101.2
unnamed: Q102.3, R102.2
unnamed: Q103.3, R103.2
unnamed: Q104.3, R104.2
unnamed: Q105.3, R105.2
unnamed: Q106.3, R106.2
unnamed: Q107.3, R107.2
unnamed: R11.1, RT2.2
unnamed: R12.1, RT4.2
unnamed: R13.1, RT6.2
unnamed: R14.1, RT8.2
unnamed: R15.1, RT10.2
unnamed: R16.1, RT12.2
unnamed: R17.1, RT14.2
unnamed: R18.1, RT16.2
unnamed: R20.1, RT18.2
unnamed: R21.1, RT20.2
unnamed: R22.1, RT22.2
unnamed: R23.1, RT24.2
unnamed: R24.1, RT26.2
unnamed: R25.1, RT28.2
unnamed: R26.1, RT30.2
unnamed: R27.1, RT32.2
unnamed: R28.1, RT34.2
unnamed: R29.1, RT36.2
unnamed: R30.1, RT38.2
unnamed: R31.1, RT40.2
unnamed: R32.1, RT42.2
unnamed: R33.1, RT44.2
unnamed: R34.1, RT46.2
unnamed: R35.1, RT48.2
unnamed: R36.1, RT50.2
unnamed: R37.1, RT52.2
unnamed: R38.1, RT54.2
unnamed: R39.1, RT56.2
unnamed: R40.1, RT58.2
unnamed: R41.1, RT60.2
unnamed: R42.1, RT62.2
unnamed: R43.1, RT64.2
unnamed: R44.1, RT66.2
unnamed: R45.1, RT68.2
unnamed: R46.1, RT70.2
unnamed: R47.1, RT72.2
unnamed: R48.1, RT74.2
unnamed: R49.1, RT76.2
unnamed: R50.1, RT78.2
unnamed: R51.1, RT80.2
unnamed: R52.1, RT82.2
unnamed: R53.1, RT84.2
unnamed: R54.1, RT86.2
unnamed: R55.1, RT88.2
unnamed: R56.1, RT90.2
unnamed: R57.1, RT92.2
unnamed: R58.1, RT94.2
unnamed: R59.1, RT96.2
unnamed: R60.1, RT98.2
unnamed: R61.1, RT100.2
unnamed: R62.1, RT102.2
unnamed: R63.1, RT104.2
unnamed: R64.1, RT106.2
unnamed: R65.1, RT108.2
unnamed: R66.1, RT110.2
unnamed: R67.1, RT112.2
unnamed: R68.1, RT114.2
unnamed: R69.1, RT116.2
unnamed: R70.1, RT118.2
unnamed: R71.1, RT120.2
unnamed: R72.1, RT122.2
unnamed: R73.1, RT124.2
unnamed: R74.1, RT126.2
unnamed: R75.1, RT128.2
unnamed: R76.1, RT130.2
unnamed: R77.1, RT132.2
unnamed: R78.1, RT134.2
unnamed: R79.1, RT136.2
unnamed: R80.1, RT138.2
unnamed: R81.1, RT140.2
unnamed: R82.1, RT142.2
unnamed: R83.1, RT144.2
unnamed: R84.1, RT146.2
unnamed: R85.1, RT148.2
unnamed: R86.1, RT150.2
unnamed: R87.1, RT152.2
unnamed: R88.1, RT154.2
unnamed: R89.1, RT156.2
unnamed: R90.1, RT158.2
unnamed: R91.1, RT160.2
unnamed: R92.1, RT162.2
unnamed: R93.1, RT164.2
unnamed: R94.1, RT166.2
unnamed: R95.1, RT168.2
unnamed: R96.1, RT170.2
unnamed: R97.1, RT172.2
unnamed: R98.1, RT174.2
unnamed: R99.1, RT176.2
unnamed: R100.1, RT178.2
unnamed: R101.1, RT180.2
unnamed: R102.1, RT182.2
unnamed: R103.1, RT184.2
unnamed: R104.1, RT186.2
unnamed: R105.1, RT188.2
unnamed: R106.1, RT190.2
unnamed: R107.1, RT192.2
unnamed: R108.2, XA1.A0

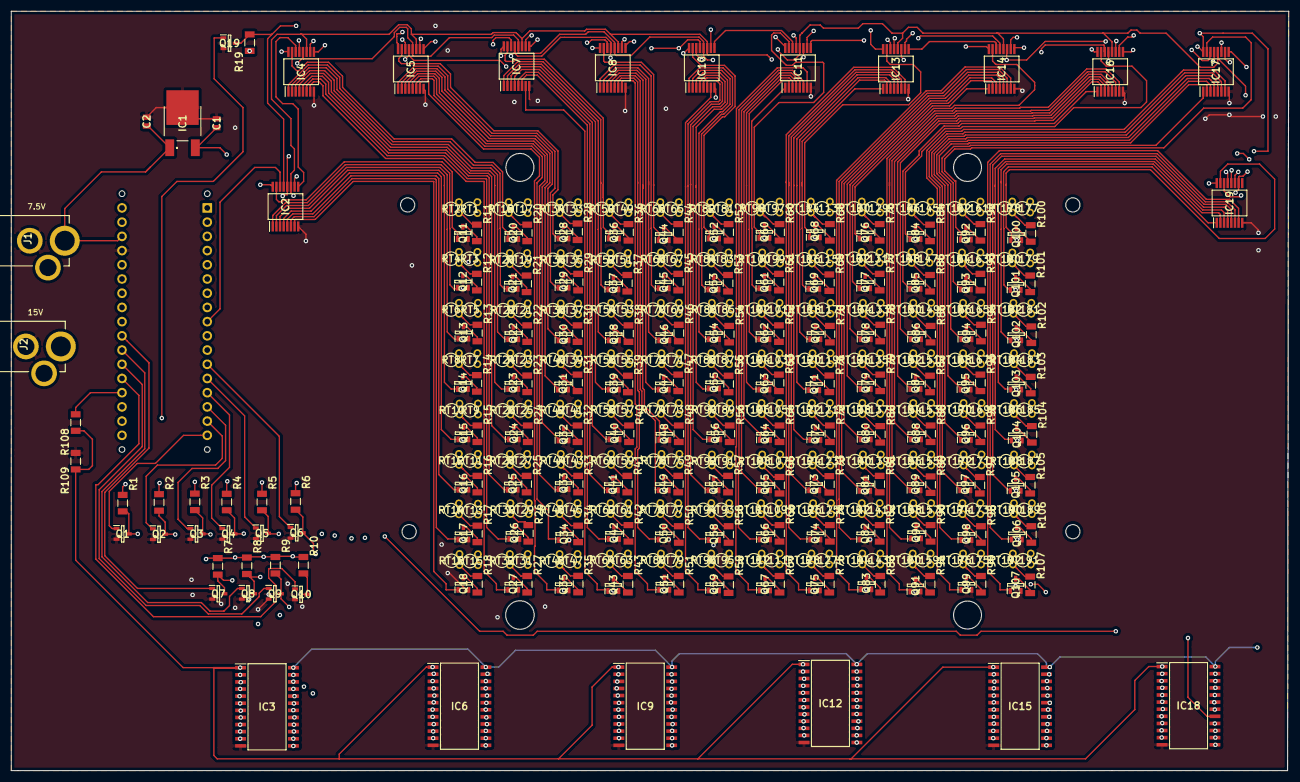
[picture p14: board ThermoPlate2_v1.kicad_pcb from above]

Board: 4 copper layers, 228.3 x 135.7 mm, 432 parts (1 on the bottom side), 426 nets.
